Candymds/skeleton_3d/stl/test/pedestal_ensamblado.stl

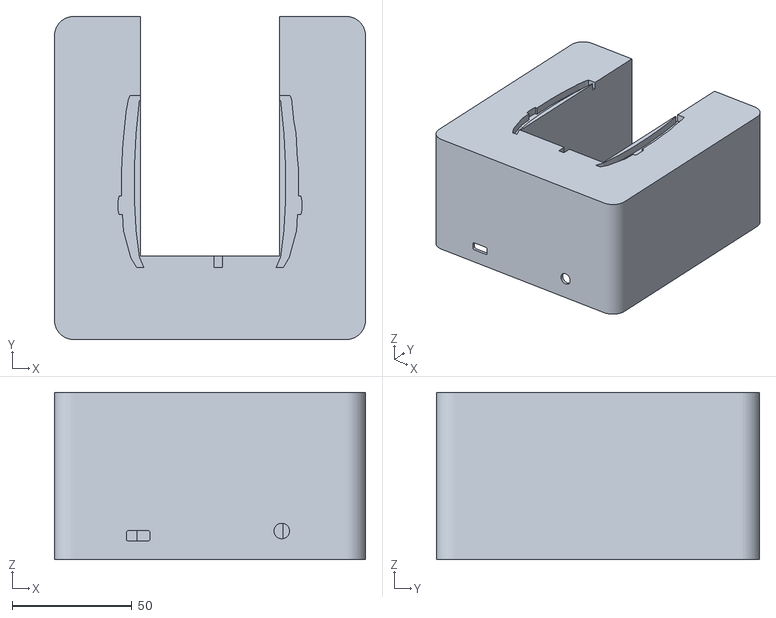
[picture p1: CAD file, 2026-10-20]
stl/test/pedestal_ensamblado.stl
130.0 x 135.0 x 70.0
