Candymds/skeleton_3d/stl/test/tapa_inferior_ensamblada.stl

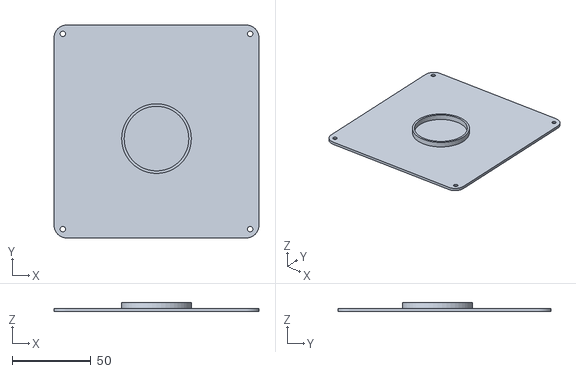
[picture p2: CAD file, 2026-10-20]
stl/test/tapa_inferior_ensamblada.stl
130.0 x 135.0 x 6.00
