Candymds/skeleton_3d/stl/test/mandibula_ensamblada.stl

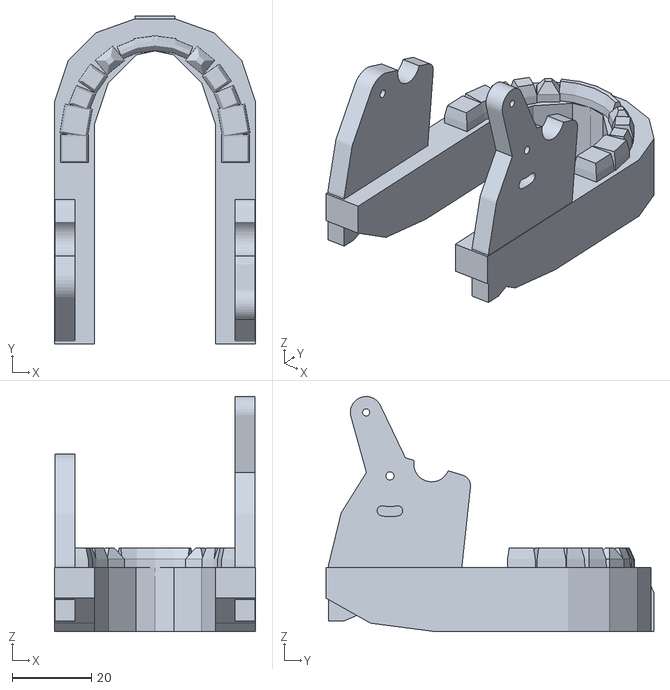
[picture p3: CAD file, 2026-10-19]
stl/test/mandibula_ensamblada.stl
50.7 x 82.6 x 59.2
