Candymds/skeleton_3d/stl/test/tapa_ensamblada.stl

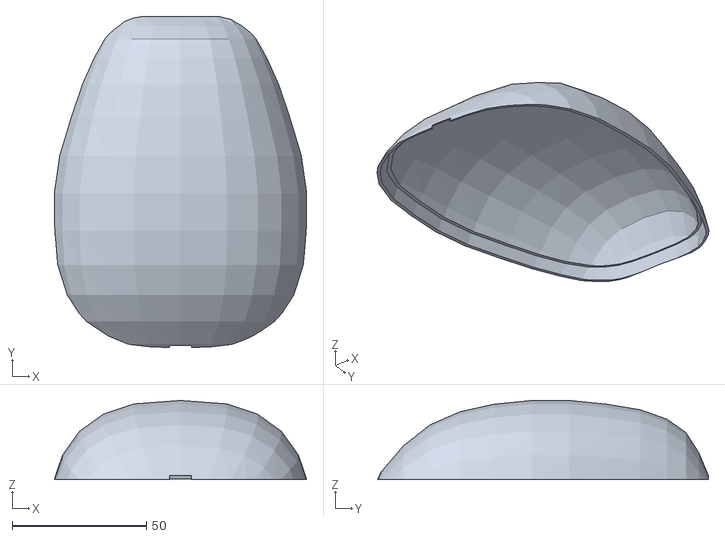
[picture p4: CAD file, 2026-10-19]
stl/test/tapa_ensamblada.stl
93.9 x 123.1 x 29.4
