Candymds/skeleton_3d/stl/craneo.stl

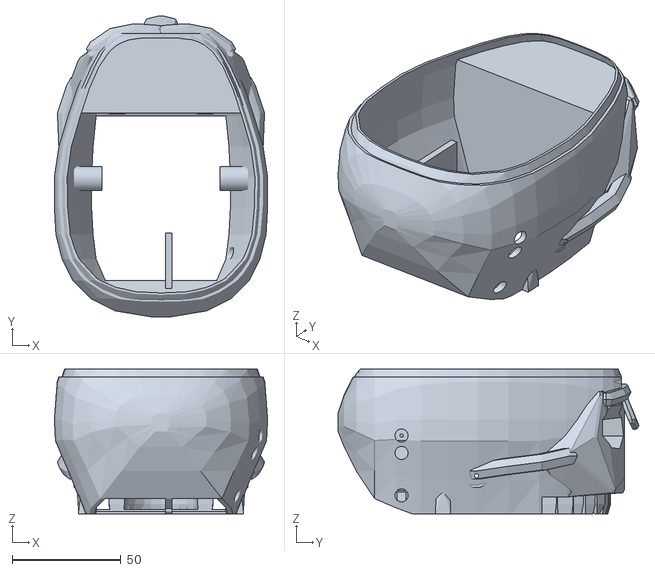
[picture p5: CAD file, 2026-10-19]
stl/craneo.stl
98.0 x 138.3 x 66.5
