Candymds/skeleton_3d/stl/test/servo.stl

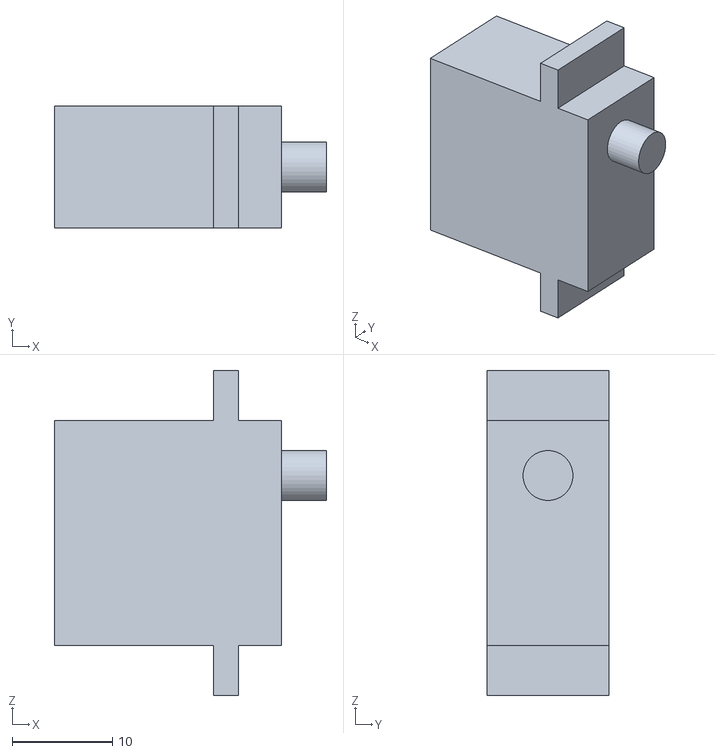
[picture p6: CAD file, 2026-10-19]
stl/test/servo.stl
27.2 x 12.2 x 32.5
