Candymds/skeleton_3d/stl/test/perno.stl

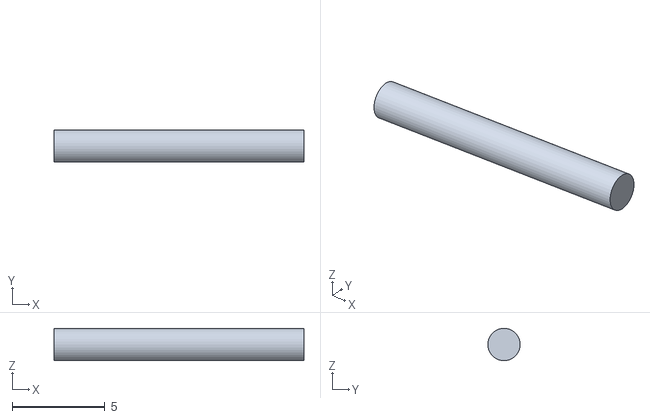
[picture p7: CAD file, 2026-10-19]
stl/test/perno.stl
13.5 x 1.75 x 1.75
