Candymds/skeleton_3d/stl/enlace.stl

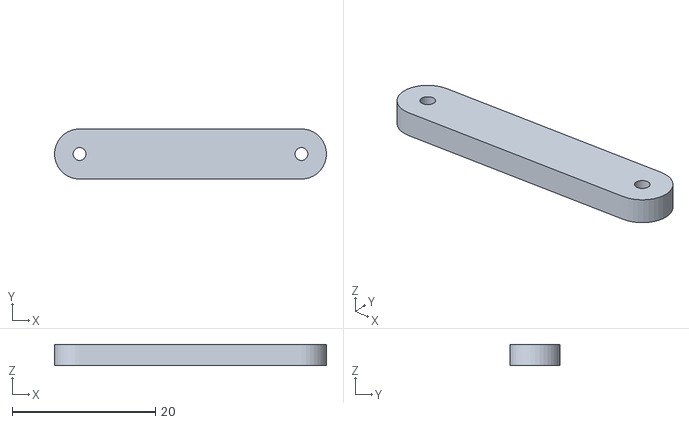
[picture p8: CAD file, 2026-10-19]
stl/enlace.stl
38.0 x 7.00 x 3.00
