Candymds/skeleton_3d/(list of files, cad)

Other CAD files:
stl/pedestal.stl
stl/tapa_inferior.stl
stl/tapa.stl
stl/mandibula.stl
