Candymds/skeleton_3d/(commit log)

2026-10-19 Modelo imprimible de cráneo articulado con mandíbula accionada por servo
    Cráneo low poly paramétrico en OpenSCAD (escala 70 %) con anatomía
    reconocible, mandíbula móvil de 0° a 30° y mecanismo servo SG90/MG90S →
    horn → enlace → palanca. El cráneo se divide en cuerpo y tapa superior
    removible para ensamblar sin pegar piezas.
    - skull.scad, anatomy.scad, params.scad: modelo y parámetros
    - stl/: craneo, tapa, mandibula y enlace listos para imprimir
    - tools/: cinemática, verificación de mallas, ensamblaje y anatomía,
    y generador del visor 3D (viewer.html)
    - openspec/: propuesta, especificaciones, diseño y tareas del cambio
    - README.md: materiales, soportes y orden de monta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
    [anatomy.scad, craneo.stl, enlace.stl, mandibula.stl, mandibula_ensamblada.stl, params.scad, perno.stl, servo.stl]
2026-10-19 Añade un pedestal que levanta el cráneo y deja libre la mandíbula
    Caja hueca con un pozo central para la mandíbula, una ranura que recibe el
    aro de la base del cráneo (calculada con cranium()) y compartimentos para
    ESP32, batería, audio y lastre. Tapa inferior con aro para altavoz de 40 mm.
    Incluye tools/check_pedestal.py y la propuesta OpenSpec add-pedestal.
    Claude-Session: https://claude.ai/code/session_01K8DCYJuakHcEpSjpYp5dRH
    [params.scad, pedestal.scad, pedestal.stl, pedestal_ensamblado.stl, tapa_inferior.stl, tapa_inferior_ensamblada.stl]
2026-10-19 Muestra el pedestal en el visor 3D
    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
2026-10-20 Aligera el pedestal: paredes de 1.6 mm y tapa inferior de 2 mm
    Nuevo parámetro ped_wall para que las paredes del pedestal no dependan
    de wall (el cráneo sigue con 2.4 mm). Ahorra unos 60 g de filamento.
    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
    [params.scad, pedestal.scad, pedestal.stl, pedestal_ensamblado.stl, tapa_inferior.stl, tapa_inferior_ensamblada.stl]
